Sunyoup/LORA1280-T_ESP32-S3_1.9inch/(commit log)

2026-10-29 Initial commit: LORA1280-T (SX1280) + ESP32-S3 1.9" LCD
    - esp-idf/: ESP-IDF v5.5 firmware. One firmware for all boards; the
    role (TX/RX) is picked with the KEY button and saved in NVS.
    RadioLib on SPI3 with DIO1 interrupts and FreeRTOS semaphores,
    ST7789 status screens via esp_lcd, battery voltage readout.
    - arduino/: original Arduino sketches (TX, blocking RX, interrupt RX).
    - README with wiring, build steps, lessons learned and a note on the
    Korean 2.4 GHz regulations.
2026-10-29 README: match screen table to photo, add where to buy
    - Swap the screen description columns so RX (left) and TX (right)
    match the photo.
    - Add product pages for the ESP32-S3 1.9" LCD board (TZT store) and
    the NiceRF LORA1280-T, and note both are sold on AliExpress.
